bluetobits/mimic009points/(commit log)

2024-10-04 Create README.md
    Specs and wiring
2024-10-04 Update README.md
    Added specs, features and wiring
2024-10-08 Added I2C slave sensor facility not impllemented
2024-10-14 Added additions. Moved current to old
2024-11-22 Debug print changes moved CMRI process
